db-electronics/c64-cart-kicad/README.md

# Copyright and Disclaimer
Copyright: René Richard

This documentation describes Open Hardware and is licensed under the
CERN OHL v. 1.2.

You may redistribute and modify this documentation under the terms of the
CERN OHL v.1.2. (http://ohwr.org/cernohl). This documentation is distributed
WITHOUT ANY EXPRESS OR IMPLIED WARRANTY, INCLUDING OF
MERCHANTABILITY, SATISFACTORY QUALITY AND FITNESS FOR A
PARTICULAR PURPOSE. Please see the CERN OHL v.1.2 for applicable
conditions

# Commodore 64 Flash Cartridge
A simple rewritable game flash cartridge for the Commodore 64. Compatible with the [Universal Mega Dumper](https://github.com/db-electronics/Universal-Mega-Dumper).
