db-electronics/c64-cart-kicad/c64-cart/sch/c64-cart_v0.1.pdf

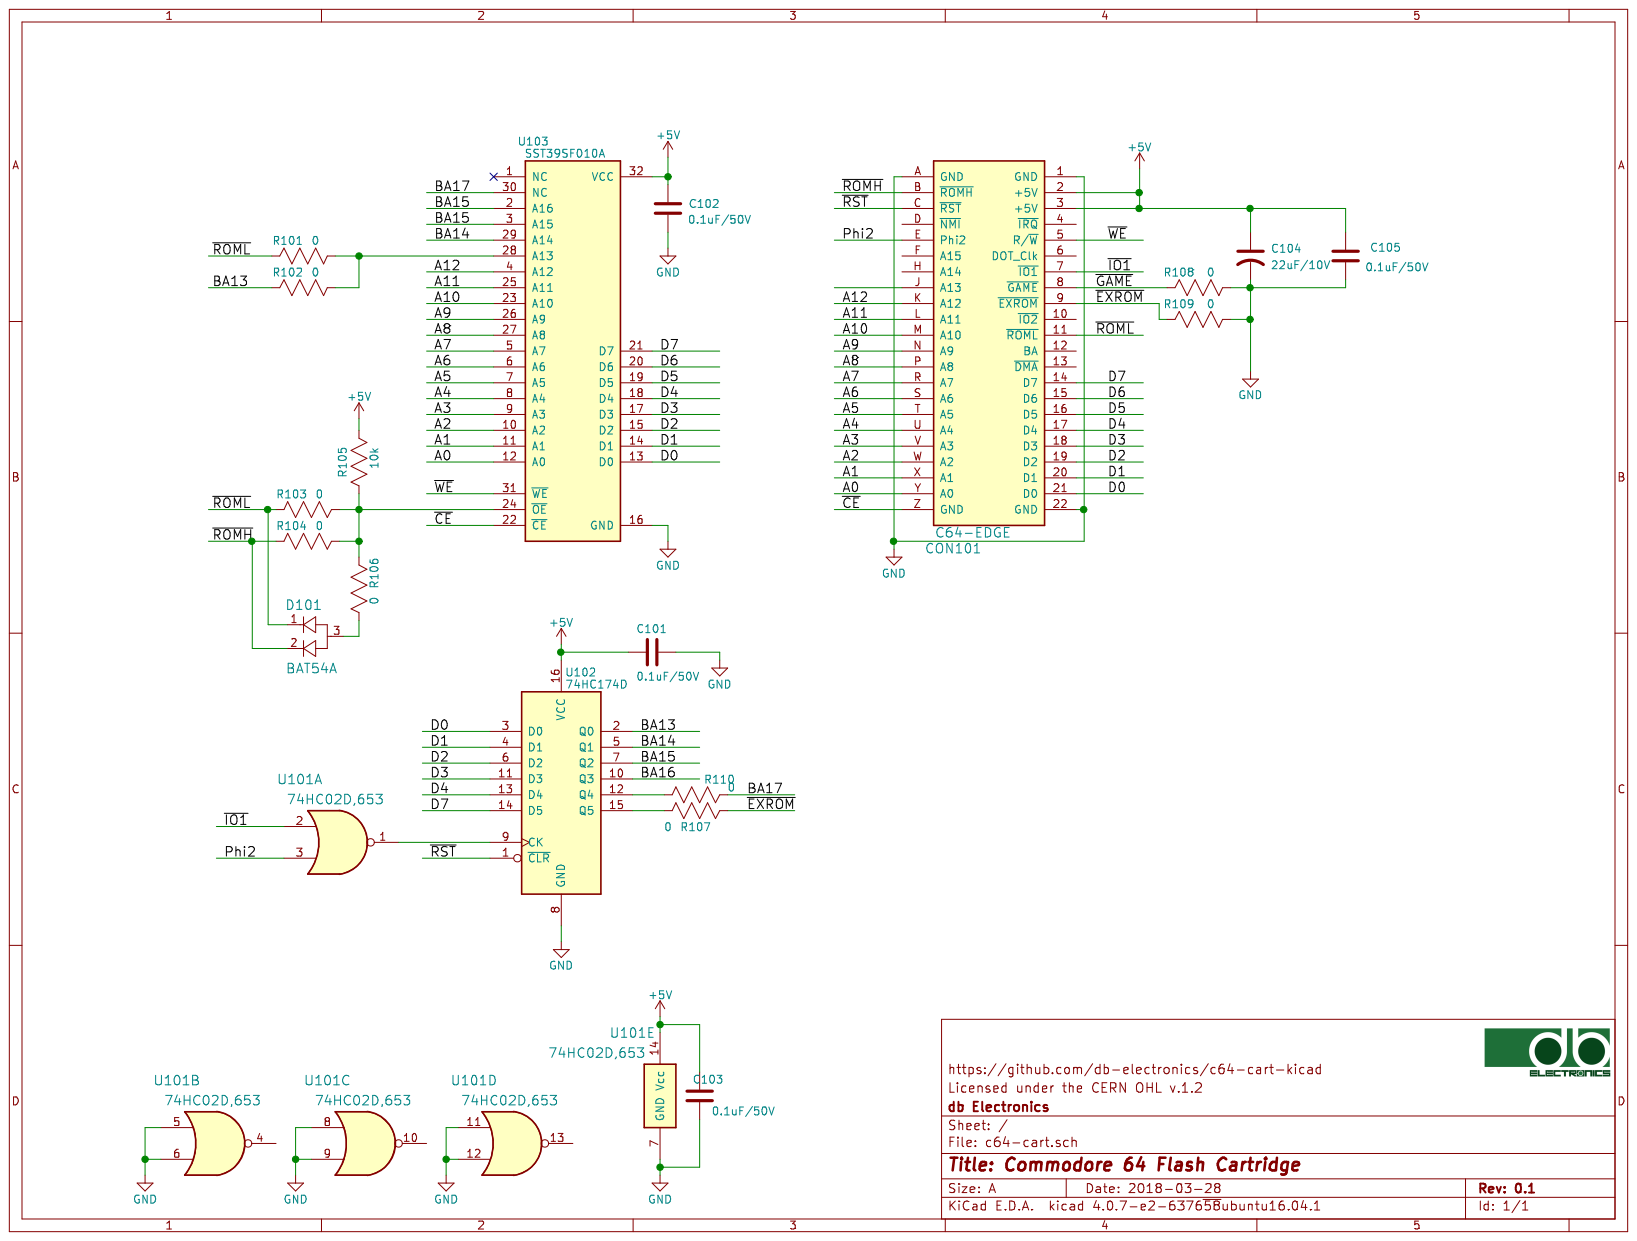
[picture p1: page 1]
