db-electronics/c64-cart-kicad/(commit log)

2018-02-16 initial file commit
    [c64-cart.kicad_pcb, c64-cart.sch]
2018-02-16 parts placement on PCB begun
    [c64-cart.kicad_pcb, c64-cart.sch]
2018-02-16 adding features to permit 8K, 16K, etc... carts
    [c64-cart.sch]
2018-02-27 added 8K/16K 0 ohm res options
    [c64-cart.kicad_pcb, c64-cart.sch]
2018-03-09 placing parts
    [c64-cart.kicad_pcb, c64-cart.sch]
2018-03-13 updated pcb edge symbol
    [c64-cart.kicad_pcb, c64-cart.sch]
2018-03-28 added BA17 line to ROM
    [c64-cart.kicad_pcb, c64-cart.sch]
2018-03-28 generated v0.1 gerbers and BOM
    [c64-cart-B.Cu.gbl, c64-cart-B.Mask.gbs, c64-cart-B.Paste.gbp, c64-cart-B.SilkS.gbo, c64-cart-Edge.Cuts.gm1, c64-cart-F.Cu.gtl, c64-cart-F.Mask.gts, c64-cart-F.Paste.gtp]
